jschneider33/openflight/cad/IARC_case/step/KLD7_h_mount_L.step

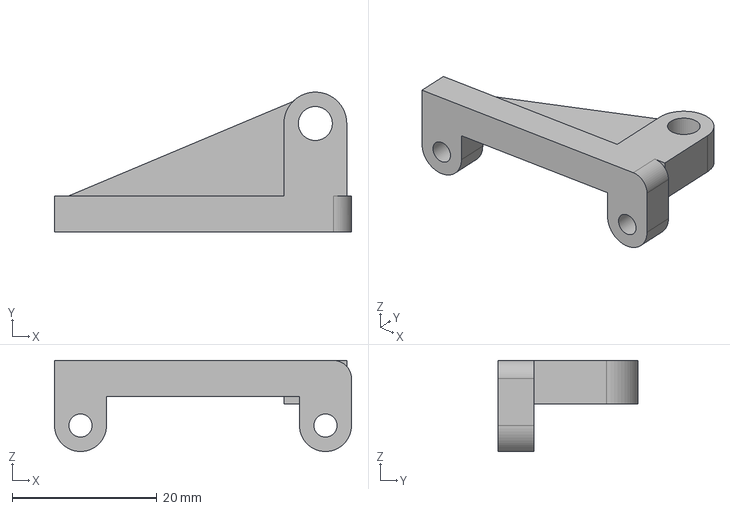
[picture p13: CAD file, 2026-04-06]
cad/IARC_case/step/KLD7_h_mount_L.step
41.1 x 19.3 x 12.6 mm
