jschneider33/openflight/cad/IARC_case/step/outer_case_bottom.step

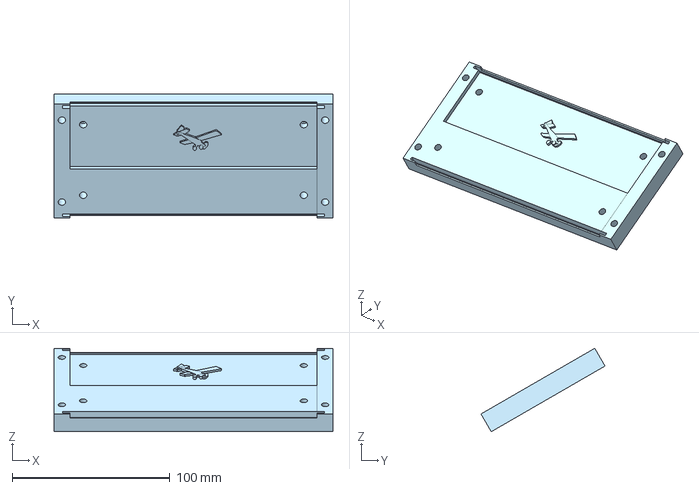
[picture p14: CAD file, 2026-04-06]
cad/IARC_case/step/outer_case_bottom.step
177.0 x 78.7 x 52.9 mm
