jschneider33/openflight/cad/IARC_case/step/case_foot.step

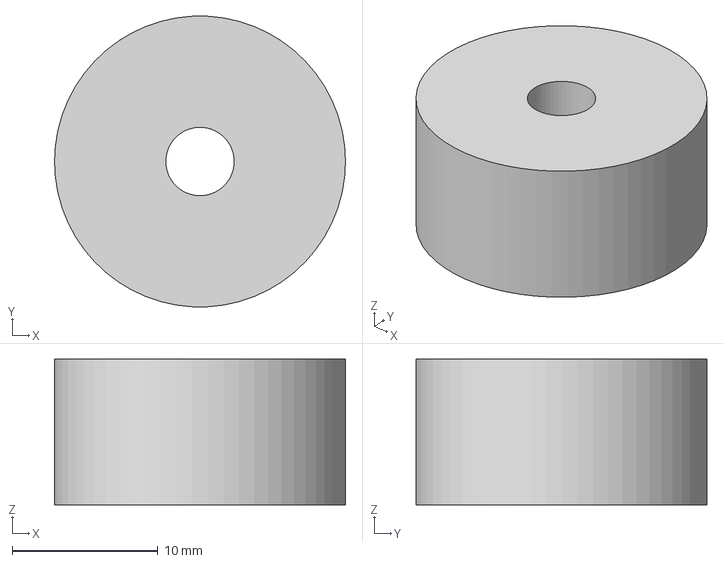
[picture p15: CAD file, 2026-04-06]
cad/IARC_case/step/case_foot.step
20.0 x 20.0 x 10.0 mm
