jschneider33/openflight/cad/IARC_case/step/OPS_mount.step

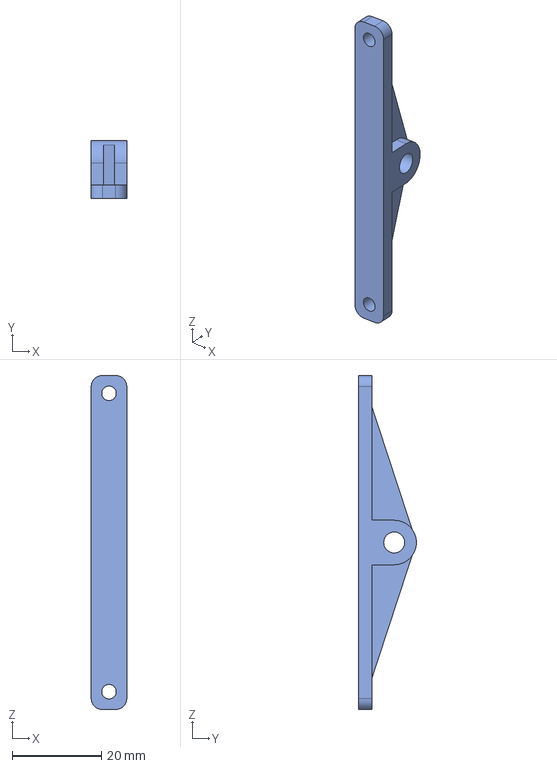
[picture p16: CAD file, 2026-04-06]
cad/IARC_case/step/OPS_mount.step
8.00 x 13.0 x 75.0 mm
