jschneider33/openflight/cad/IARC_case/step/outer_case_top.step

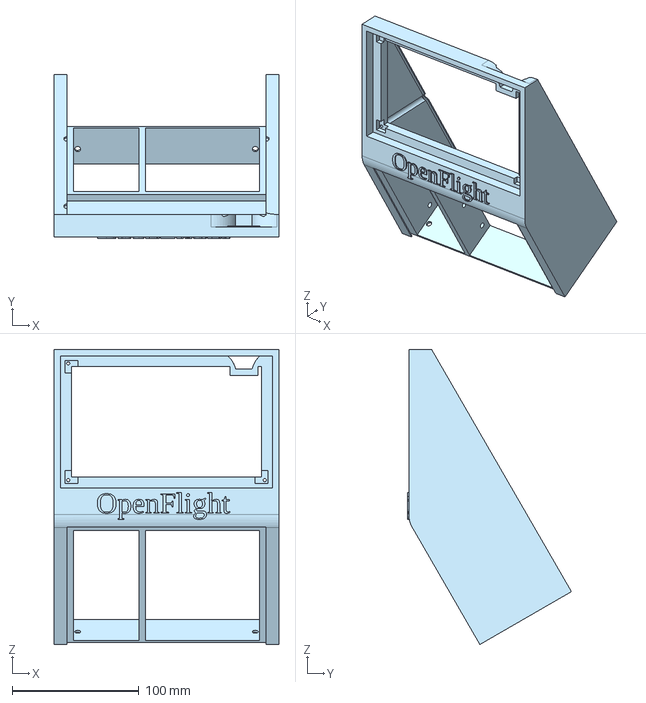
[picture p17: CAD file, 2026-04-06]
cad/IARC_case/step/outer_case_top.step
177.0 x 129.2 x 232.5 mm
