jschneider33/openflight/cad/IARC_case/step/KLD7_v_mount_R.step

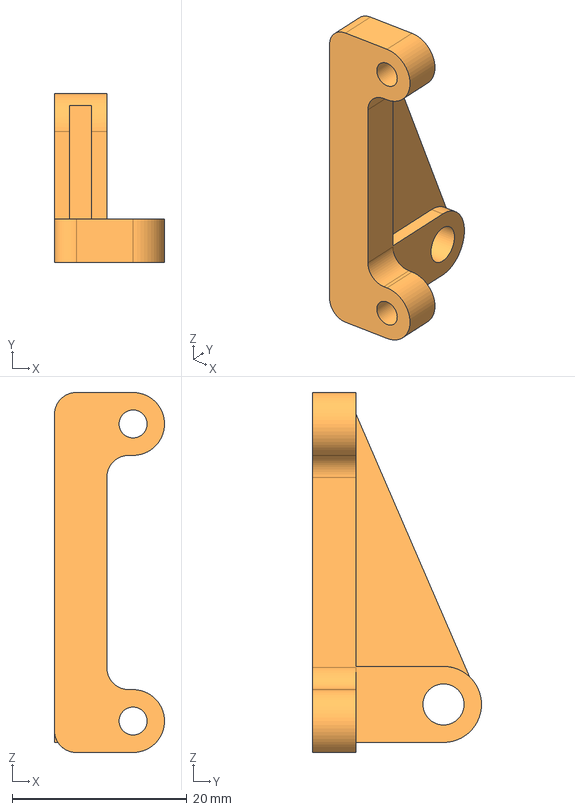
[picture p18: CAD file, 2026-04-06]
cad/IARC_case/step/KLD7_v_mount_R.step
12.6 x 19.4 x 41.2 mm
