jschneider33/openflight/(list of files, cad)

Other CAD files:
cad/IARC_case/step/KLD7_h_mount_R.step
cad/IARC_case/step/KLD7_v_mount_L.step
cad/IARC_case/stl/KLD7_h_mount_L.stl
cad/IARC_case/stl/KLD7_h_mount_R.stl
cad/IARC_case/stl/KLD7_v_mount_L.stl
cad/IARC_case/stl/KLD7_v_mount_R.stl
cad/IARC_case/stl/OPS_mount.stl
cad/IARC_case/stl/case_foot.stl
cad/IARC_case/stl/outer_case_bottom.stl
cad/IARC_case/stl/outer_case_top.stl
