jschneider33/openflight/(commit log)

2026-04-06 feat(kld7): wire OPS243 ball speed into RADC interferometric angle pipeline
    - KLD7Frame gains radc field for raw ADC bytes
    - _stream_loop subscribes to FrameCode.RADC alongside PDAT/TDAT
    - _configure_for_golf sets RBFR=1 to enable RADC output at 3Mbaud
    - get_angle_for_shot accepts ball_speed_mph; routes to _extract_ball_radc
    when RADC frames are present, falling back to PDAT otherwise
    - _extract_ball_radc calls extract_launch_angle() from kld7_radc_lib with
    ops243_ball_speed_mph to pin FFT search to the exact aliased velocity bin
    - snapshot_buffer includes radc bytes for correlation logging
    - server passes ball_speed_mph instead of club to get_angle_for_shot
    - Tests: RADC path preferred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
    [server.py, test_kld7.py, tracker.py, types.py]
2026-04-06 fix(tests): update StubTracker.get_angle_for_shot to accept ball_speed_mph
    [test_server.py]
2026-04-26 spec(gspro): OpenConnectV1 TCP client with model fallback
    Optional TCP integration with GSPro that streams shots over the
    OpenConnectV1 protocol (port 921, persistent socket, JSON). Adds a
    new src/openflight/gspro/ module wired into the server only when
    enabled via config or CLI flag.
    Each missing measurement falls back to a model (per-club optimal
    launch, per-club spin, D-plane spin axis), and per-field provenance
    (measured vs estimated) flows to the UI as badges so the user sees
    exactly which fields the hardware produced.
2026-04-26 plan(gspro): TDD implementation plan for OpenConnectV1 integration
    14 tasks covering module skeleton, OpenConnectV1 messages, shot builder
    with fallback table and provenance, TCP client with state machine and
    heartbeat, server wiring, CLI flag forwarding, UI status pill and
    per-shot badges, docs, and end-to-end manual verification.
2026-04-26 feat(gspro): heartbeat thread with idle-suppression
    Adds a background heartbeat thread to GSProClient that fires when the
    connection has been idle longer than heartbeat_interval_s. Heartbeats
    bypass _last_send_time tracking so they don't suppress themselves.
    Updates __init__.py to re-export StatusEvent and all public symbols.
2026-04-26 feat(gspro): wire client into server with shot listener and player updates
    Adds CLI flags (--gspro, --no-gspro), module-level GSProClient lifecycle
    (start/stop in main and shutdown handler), shot forwarding via
    build_gspro_payload after socketio.emit("shot"), and player-update
    callback that calls monitor.set_club() to keep club state in sync.
2026-04-26 fix(gspro): TCP framing buffer + non-Optional gspro_cfg default
    - _recv_loop now accumulates bytes into a buffer and uses a string-aware
    brace counter to extract complete top-level JSON objects. Previously a
    single recv() was passed straight to parse_response, so a partial frame
    or coalesced frames would silently log "malformed response" and lose
    the message (especially a code-201 player update).
    - gspro_cfg is now initialized to GSProConfig() instead of None, matching
    how on_shot_detected uses it (.device_id / .units never gated by an
    Optional check).
    - New tests/test_gspro_client_framing.py covers nine framing edge cases
    (partial, concatenated, nested, escaped quotes, non-ASC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
    [server.py, test_gspro_client_framing.py]
2026-05-02 [cr] fix horizontal angle dropout for ball speeds near aliasing wraparound
    [diagnose_horizontal_angle.py, illustrate_centroid_vs_peak.py, radc.py, test_kld7_radc_lib.py]
2026-05-04 [cr] fix kld7 header reading
    [serial_io.py]
2026-05-27 [cr] fix stream error on kld7
    [serial_io.py, test_kld7.py, tracker.py]
2026-05-27 [cr] slightly throttle kld7 stream
2026-05-27 [cr] slightly throttle kld7 stream more
2026-05-31 start-kiosk.sh: forward K-LD7 geometry flags + fix venv hint
    Add --kld7-vertical-estimator / --kld7-mount-tilt / --kld7-ball-distance
    passthrough (only forwarded when set, so server defaults still apply), and
    correct the "venv not found" hint to install the kld7 extra ('.[ui,kld7]')
    since radar use needs the kld7 package.
2026-05-31 Fix OPS243 test import order
    [test_ops243.py]
2026-05-31 Fix Python 3.10 test collection
    [review_kld7_session.py, test_project_metadata.py]
2026-06-02 feat: add physics-based ball flight simulator
    Adds `ballistics.py` with a deterministic drag + Magnus ODE simulator
    (RK4, 500 Hz) and a `resolve_launch()` helper that substitutes
    club-typical spin when measured spin confidence is below the "high"
    threshold. Output is a single committed trajectory — no probabilistic
    range — so it composes cleanly with future simulator handoffs.
    Aerodynamic model uses Hill-type Cl(Sp) and linear Cd(Sp) fits
    consistent with Bearman & Harvey (1976) and Kensrud & Smith (2018)
    for dimpled balls past the drag crisis. Spin decays exponentially
    at 4%/s per Kiratidis & Leinweber (2018).
    No UI or server changes — module is standalone. Tests cover
    launch-resolut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
    [ballistics.py, test_ballistics.py]
2026-06-04 Add ballistics validation + Cd/Cl coefficient sweep tooling
    scripts/analysis/validate_ballistics.py runs the model on TrackMan
    inputs (physics-only check) and on OpenFlight inputs (end-to-end check),
    comparing each prediction to TrackMan's normalized flat carry. Air
    density defaults to 1.184 kg/m^3 to match TM's 77F/sea-level
    normalization. Per-shot CSV, per-club + per-session stats, and a
    scatter plot per source.
    scripts/analysis/sweep_ballistic_coeffs.py fits the four
    ballistics.py aero constants (CD_BASE, CD_SPIN_COEFF, CL_SATURATION,
    CL_HALF_SP) via differential-evolution + Nelder-Mead refinement against
    TrackMan flat carry. Optional --loso flag does leave-one-session-out
    cross-validati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
2026-06-04 Add --no-ballistics toggle to fall back to legacy table carry
    server.py: new --no-ballistics CLI flag (default off, i.e. ballistics
    on). When set, on_shot_detected skips resolve_launch/simulate entirely
    and routes every non-mock shot through the table-based estimator. The
    table-path log message now identifies which condition triggered the
    fallback (no launch angle vs ballistics disabled), and the chosen mode
    is announced at server startup.
    start-kiosk.sh: parses --no-ballistics, forwards it to the server
    command, and logs the mode alongside the existing camera/trigger lines.
    tests/test_server.py: new test_carry_skips_ballistic_when_ballistics_disabled
    that pins the contract — when the fl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
    [server.py, test_server.py]
2026-06-09 Default ballistics off; rename flag to --ballistics opt-in
    Flip ballistics_enabled default to False so all shots use the legacy
    table estimator unless the user opts in with --ballistics (CLI) or
    --ballistics (start-kiosk.sh). Keeps the simulator available for A/B
    work while Cd/Cl coefficients are still being validated against TM.
    [server.py, test_server.py]
2026-06-10 Fix K-LD7 ring buffer race that silently dropped launch angles
    The K-LD7 stream thread appends frames to the ring buffer at ~34 Hz
    while the OPS243 shot path iterates the same deque in snapshot_buffer()
    and _radc_frames_for_extraction(). CPython raises "RuntimeError: deque
    mutated during iteration" when an append lands mid-iteration; the
    server-side K-LD7 exception handler swallows it, so the shot is
    reported without a launch angle and no error is ever surfaced.
    - Add a threading.Lock created alongside the ring buffer
    - _add_frame() and reset() mutate the deque under the lock
    - snapshot_buffer() and _radc_frames_for_extraction() copy the deque
    under the lock and do per-frame work (dict bu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
    [test_kld7.py, tracker.py]
2026-06-11 [cr] add kld7 dc-alias blind zone flag and sub-frame fringe instrumentation, cleanup old session logs
2026-06-13 fix(ops): don't truncate buffer dump when trigger fires near timeout
    wait_for_hardware_trigger bounded TOTAL elapsed time, so a sound
    trigger firing in the last ~5s of the 30s wait window had its ~46KB
    rolling-buffer dump cut off mid-stream at the deadline ("Incomplete
    capture (missing: Q)"), silently losing the shot. At a 30s re-arm
    cadence that's roughly 1 in 6 random impacts.
    Once the first byte arrives the trigger has fired and the dump is in
    flight: extend the deadline to first_byte + dump_grace (8s, vs the
    ~4-5s a dump actually takes). The existing completeness and inactivity
    exits still return as soon as the Q array closes.
    [ops243.py, test_ops243.py]
2026-06-13 feat(sim): protocol-agnostic connector core + GSPro codec (Phase 1)
    Extract a sim-neutral connector framework from Coleman's GSPro integration:
    - sim/transport.py: TcpSimClient (lifecycle, reconnect/backoff, JSON framing,
    optional codec-driven heartbeat)
    - sim/resolver.py: shared Shot->ResolvedShot fallback table + provenance
    - sim/types.py: ConnectionState, PlayerState, ResolvedShot, inbound events
    - sim/codec.py: SimConnector + codec registry (build_connector)
    - gspro/codec.py: OpenConnectV1 serialize/parse behind the Codec interface
    GSPro behavior is preserved; all connector/resolver/codec/transport tests pass
    (70 tests). Server wiring and config migration follow in Phase 2.
    Co-Author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
    [test_gspro_codec.py, test_gspro_messages.py, test_gspro_state.py]
2026-06-13 feat(sim): server registry, sim.json config, generic sim_* events (Phase 2)
    - sim/config.py: config/sim.json + CLI merge (ConnectorConfig list); replaces
    the GSPro-specific config loader
    - server.py: holds list[SimConnector]; _forward_shot_to_simulators resolves a
    shot once and fans out to every connected connector; _sim_on_status /
    _sim_on_inbound relay generic sim_status / sim_shot / sim_player WS events;
    --gspro / --opengolfsim / --no-sim flags; connectors stopped on shutdown
    - session_logger: log_sim_send / log_sim_status / log_sim_player
    - config/sim.example.json + gitignore config/sim.json
    Existing server suite unchanged (88 passed); sim suite 80 passed; pylint 9.21.
    Co-Autho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
    [server.py, session_logger.py, test_sim_config.py, test_sim_connector.py, test_sim_server_wiring.py, types.py]
2026-06-13 feat(opengolfsim): OpenGolfSim connector codec (Phase 3)
    - opengolfsim/codec.py: documented outbound shot ({type:shot,unit,shot:{...}})
    and device-ready on connect; no heartbeat; best-effort inbound player parse
    - opengolfsim/clubs.py: lenient name/abbreviation club mapping (UNVERIFIED
    inbound, clearly marked; outbound does not depend on it)
    - registry already routes type "opengolfsim"; concurrent GSPro+OGS integration
    test confirms one shot reaches both sims in their own wire formats
    - race-safe fix in mock sim server disconnect_client
    112 sim/connector tests pass; pylint 9.51.
    [test_opengolfsim_codec.py, test_sim_concurrent.py]
2026-06-13 fix(opengolfsim): parse club from documented nested player message
    Inbound club sync read obj["club"] at the top level, but OpenGolfSim's player
    message nests it under "data" ({"type":"player","data":{"club":{...}}}), so club
    updates never applied. Read data.club (flat fallback retained) and map the
    two-letter id/name.
    Also: omit the "unit" field for imperial shots to match OGS's documented wire
    format (only metric is tagged). Docs clarify club selection is one-way
    (simulator -> OpenFlight); neither GSPro nor OpenGolfSim accepts an outbound
    club set from the launch monitor.
    733 tests pass; pylint 9.67; ruff clean.
    [test_opengolfsim_codec.py]
2026-06-13 feat(sim): terminal logging for connector traffic
    Add [sim] terminal logs for connector activity:
    - connection lifecycle (connected / reconnecting / error) and inbound club
    updates log at INFO always (low-volume, useful when validating club sync)
    - per-shot send detail and OK acks log only when debug mode is on (UI toggle),
    matching the existing debug-shot logging pattern
    Outbound: [sim] → <target> shot #N: ball=… vla=… spin=… (NM/ME)
    Inbound: [sim] ← <target> player update: club=…
    Lifecycle: [sim] <target> connected (host:port)
    736 tests pass; pylint 9.69.
    [server.py, test_sim_server_wiring.py]
2026-06-13 chore(sim): raw sim probe tool + document OGS club-update gap
    - scripts/probe_sim.py: standalone TCP probe to confirm a connection and
    capture a simulator's exact inbound wire format
    - docs: record that the live OpenGolfSim app acks device-ready ({"status":200})
    but did not emit a player message on club change in testing, so sim->OF club
    sync may be non-functional in current builds; parser is ready if/when it does
2026-06-13 chore(sim): add --newline and --coalesce-test to probe_sim
    Investigating an OpenGolfSim 400 ("Unexpected non-whitespace after JSON") seen
    when two messages arrive in one TCP read. --coalesce-test sends device-ready +
    a query in a single write to reproduce it; --newline appends a newline delimiter
    to test whether OGS frames on NDJSON (newline-delimited JSON). Validated against
    a newline-splitting stub: no delimiter -> 400, with delimiter -> 200.
2026-06-13 chore(sim): add --set-club to probe_sim to test OF->OGS club control
    OpenGolfSim won't expose its club to the device, so the achievable sync is the
    reverse: OpenFlight sets the club in OGS. --set-club sends several candidate
    "set current club" messages (newline-delimited, spaced) so we can watch the sim
    and find which shape, if any, actually changes the club there.
2026-06-15 chore(sim): drop dead-end OGS OpenConnect plugin fork; point OGS at 3111
    OGS desktop 1.13.0 doesn't load user-folder plugins, so the 921 plugin fork
    (tools/ogs-openconnect-plugin) never ran — remove it. The working club-sync
    path is the bundled Developer API on 3111 + tools/ogs-developer-api-clubsync.
    Reconcile to that reality:
    - opengolfsim+openconnect now defaults to port 3111 (OGS serves OpenConnect from
    the Developer API there; there is no 921 server), config example updated
    - docs/simulator (README + opengolfsim.md) rewritten: OGS via Developer API
    3111, club sync via the api.js patch, no 921-plugin narrative
    - test docstring reference updated
    744 tests pass; ruff clean.
    Co-Aut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
    [test_gspro_state.py, test_sim_config.py]
2026-06-15 [cr] fix uploads of big files with raw ADC
    [test_cloud_filtering.py]
2026-06-17 fix(sim): guard shared PlayerState with a lock (#115 review #5)
    next_shot_number() does a read-modify-write on shot_counter and apply() writes two fields; both are reachable from every connector thread. CPython's GIL makes these incidentally safe today (verified empirically: ~1.6M concurrent increments at a 1e-9 switch interval lose nothing), but that is an implementation detail. A threading.Lock makes the invariants explicit and correct under free-threaded builds, where the GIL no longer serializes the increment.
    Adds two concurrency tests. Because the race is GIL-masked on CPython they pass with or without the lock today; they are guarantee tests that pin the contract (a unique number per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
    [test_sim_concurrent.py, types.py]
2026-06-17 Fix stale socket typing comments
2026-06-17 Clean up socket hook and shot store API
2026-06-23 Update link and price for 27W USB-C Power Supply
2026-06-25 fix(sim): seed ShotNumber from epoch seconds to fit GSPro's int32
    GSPro's OpenConnect ShotNumber is a signed 32-bit integer. Seeding the
    shot counter from epoch milliseconds overflowed it, so every shot was
    rejected with 501 "Bad format". Seed from epoch seconds via the new
    initial_shot_counter() helper, which stays well under 2^31 while still
    strictly increasing across restarts (some sims reject a ShotNumber <=
    the highest they've seen).
    [server.py, test_sim_types.py, types.py]
2026-06-25 fix(sim): emit connector status snapshot on UI connect
    The UI builds its simulator status pills from sim_status events, which only
    fire on connection-state changes. A client that connected or refreshed after a
    connector already settled missed those events and showed no pill — the
    intermittent "sometimes the sim status shows, sometimes it doesn't". Replay a
    snapshot of every connector's current state on connect so each enabled sim
    always has a pill.
    [server.py, test_sim_server_wiring.py]
2026-06-25 fix(sim): report Connecting (not Reconnecting) before first connect
    A failed first connect fell straight through to RECONNECT_BACKOFF, so on launch
    the pill read "Reconnecting" before any connection had been made — implying a
    connection was established and lost. Track whether we've ever connected and keep
    reporting CONNECTING during retries until the first success; reserve
    RECONNECT_BACKOFF for a connection that was established and then dropped.
    [test_sim_connector.py]
2026-06-28 fix(kld7): cap default baud at 921600 and recover at session baud
    The 3 Mbaud default was unreachable with the actual K-LD7 wiring on
    this Pi (external USB-to-serial + jumper wires to the radar UART
    pins): both boards failed the 115200→3M INIT handshake with framing
    errors / garbage bytes during GRPS. Per-board signal-integrity
    ceilings differed (one reached 2M, the other 921600), so 921600 is
    the safe ceiling for both. 921600 leaves plenty of headroom for
    RADC at golf frame rates (~17 KB/s vs. ~92 KB/s usable).
    Also rename _send_gbye_at_3mbaud → _send_gbye(port, baudrate) so the
    recovery GBYE is sent at the actual session baud — otherwise a
    stuck-prior-session recovery would now blas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
    [serial_io.py, tracker.py]
